Hover-Disaster/Strelka-Flight-Computer/Documentation/High Quality Gyro Comparison.xlsx

Name | Distributor | Price | Axes | Measurement range (deg/s) | Angular random walk (deg/h) | Bias instability (deg/h) | Sensitivity (mdeg/s/digit) | Sensitivity vs temperature (+/-) | Zero rate level (deg/s)(+/-) | Change zero rate level vs temperature (deg/s/degC)(+/-) | Linearity error | Noise density (deg/s/sqrt(Hz)) | Max output data rate (Hz)
I3G4250DTR | Mouser | $18.68 | xyz | 245-2000 |  |  | 8.75 | 2% | 10 | 0.03 | 0.20% | 0.03 | 840
IAM-20380 | Mouser | $30.72 | xyz | 250-2000 |  |  |  |  | -0.8 | 1 | 0.10% | 0.005 | 8000
ASM330LHHXTR | Mouser | $22.68 | xyz | 125-4000 | 0.21 | 3 |  | 2% | 2 |  | 0.01% | 0.005 | 6667
ADXRS453 | Digikey | $221.59 | xyz |  |  |  |  |  |  |  |  | 0.015
