Hover-Disaster/Strelka-Flight-Computer/Strelka_Flight_Computer/Strelka_Flight_Computer.kicad_pcb

## KiCad design Strelka_Flight_Computer/Strelka_Flight_Computer.kicad_pcb (2023-12-13)

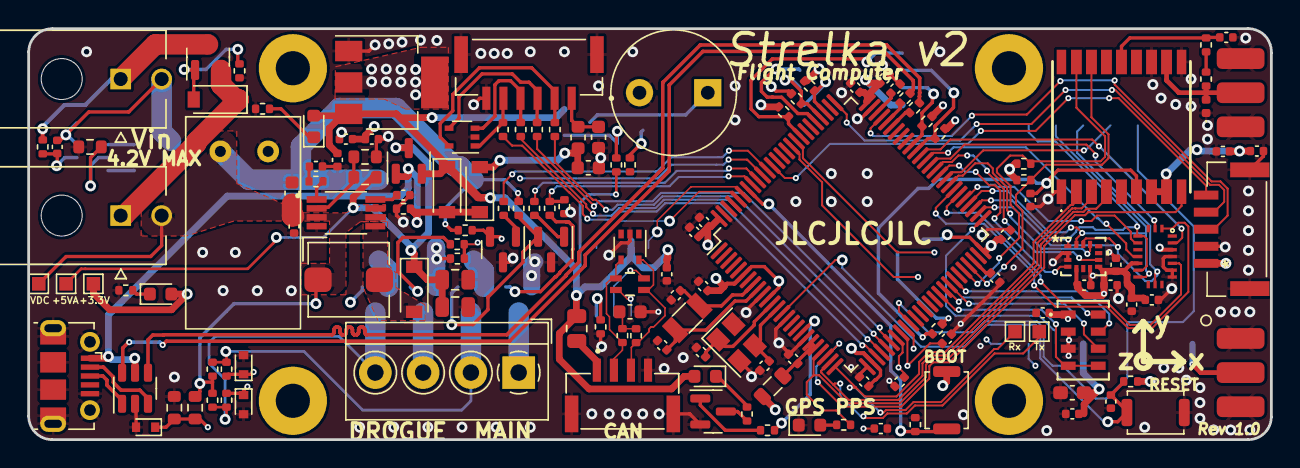
[picture p1: board Strelka_Flight_Computer.kicad_pcb from above]

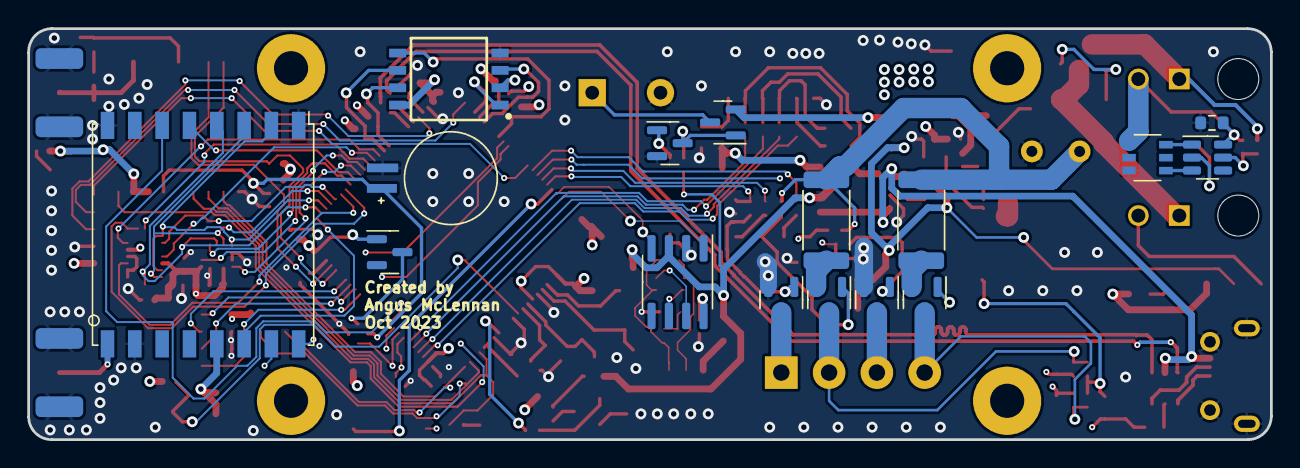
[picture p2: board Strelka_Flight_Computer.kicad_pcb from below]

Board: 4 copper layers, 91.0 x 30.1 mm, 165 parts (16 on the bottom side), 124 nets.

Parts:
AE1, AE2: Antenna_Shield; STA-10201
BT2: MS621FE-FL11E; BAT_MS621FE-FL11E
BZ3: Buzzer; HNB09A05
C1, C2, C4, C5, C6, C10, C28, C29, C30, C31, C39, C48, C50, C52, C53, C54, C60, C61, C66: 100n; C_0402_1005Metric
C3, C7, C8, C40: 10u; C_0402_1005Metric
C9, C12, C13: 10n; C_0402_1005Metric
C11: 10u; C_0603_1608Metric_Pad1.08x0.95mm_HandSolder
C14, C55: 22u; C_0805_2012Metric
C15: 4.7n; C_0603_1608Metric
C26, C27: 2.2u; C_0603_1608Metric
C37: NC; C_0402_1005Metric
C38: 4.7u; C_0402_1005Metric
C41: 1500u; ULR158M0JF1ARR
C46: 22u; C_0603_1608Metric
C47, C49: 1u; C_0402_1005Metric
C51: 2.2n; C_0402_1005Metric
C62, C63: 18p; C_0402_1005Metric
C64, C65: 15p; C_0402_1005Metric
C67, C68: 2.2u; C_0402_1005Metric
D1, D2, D4: B5819W; D_SOD-123
D3, D5, D13: BZT52C3V6T; D_SOD-523
D6, D7: SP0504BAJT; SOT-353_SC-70-5
D10: ESD9B3.3ST5G; D_0402_1005Metric
D11: BAT54C; SOT-23
D12: LED_GREEN; LED_0603_1608Metric
D14: DSK34; D_SOD-123
D18: RED LED; LED_0603_1608Metric
D19: YELLOW LED; LED_0603_1608Metric
D20: BLUE LED; LED_0603_1608Metric
F1: MF-PSHT035KX-2; R_0805_2012Metric
FB2: BLM18PG221SN1D; L_0603_1608Metric
FB3: HZ1005K182TFB03; R_0402_1005Metric
FL1: 744231121; CHIP_31121_WRE
H1, H2, H3, H4: MountingHole; MountingHole_2.5mm_Pad
IC1: XTSD04GLGEAG; SON127P800X600X95-8N
IC2: MAX-M10S-00B; MAXM10S00B
J2: Conn_01x04; JST_SM04B-GHS-TB(LF)(SN)-
J3: DB125-3.5-4P-GN-S; TerminalBlock_4Ucon_1x04_P3.50mm_Horizontal
J4: SM06B-GHS-TB(LF)(SN); JST_SM06B-GHS-TB(LF)(SN)
J6: USB_B_Micro; USB_Micro-B_Molex-105017-0001
J7: Conn_01x02; MOLEX_43045-0200
J8: Conn_01x07; SM05B-GHS-TBLFSN
L2: 6u; L_Bourns_SRP5030T
L4: 10u; L_0805_2012Metric
MOSFET1: DMG6968UDM-7
Q1, Q2: CJK2333; SOT-23
Q4, Q9, Q17: AO3401A; SOT-23
Q5, Q10: AP2300; SOT-23
Q6, Q11: MMBT2222; SOT-23
Q15, Q16: AO3400A; SOT-23
R1: 0R; R_0603_1608Metric
R2, R3, R4, R5, R6, R8, R81: 100k; R_0402_1005Metric
R7: 330R; R_0402_1005Metric
R9: 2.7k; R_0603_1608Metric
R10, R11, R12, R16, R17, R31, R51, R56, R57, R74, R77, R78, R80: 1k; R_0402_1005Metric
R13, R26: 60R4; R_0402_1005Metric
R14, R15, R61, R75, R79, R86, R87: 10k; R_0402_1005Metric
R18, R19, R21, R65, R76: 33R; R_0402_1005Metric
R20, R23, R24, R25, R35: 47k; R_0402_1005Metric
R22, R84: 10R; R_0402_1005Metric
R27, R47: 2R; R_2512_6332Metric
R55: 0R; R_0402_1005Metric
R59: 13k; R_0603_1608Metric
R60: 47k; R_0603_1608Metric
R62: 82k; R_0603_1608Metric
R63: 27k; R_0603_1608Metric
SW1: SW_DIP_x01; MOLEX_43045-0200
SW6, SW7: TS-1185-C-A-A-A; SW_Push_SPST_NO_Alps_SKRK
TP1, TP3, TP4, TP9, TP10: TestPoint; TestPoint_Pad_1.0x1.0mm
U1: ASM330LHHXTR; QFN_LHHXTR_STM
U2: AP9101CK6; SOT-23-6
U3: AMS1117-3.3; SOT-223-3_TabPin2
U4: RFM95W-915S2; HOPERF_RFM9XW_SMD
U5: MCP2551-I-SN; SOIC-8_3.9x4.9mm_P1.27mm
U6: STM32H743VITx; LQFP-100_14x14mm_P0.5mm
U8: USBLC6-2SC6; SOT-23-6
U11: BMX055
U12: MS561101BA03-50
U16: TPS61085DGKR; SOP65P490X110-8N
Y5: Q13FC1350000400; Crystal_SMD_3215-2Pin_3.2x1.5mm
Y6: X1E0000210834; Crystal_SMD_SeikoEpson_TSX3225-4Pin_3.2x2.5mm

Connections:
+3.3V: C2.1, C3.1, C4.1, C7.1, C8.1, C10.1, C11.1, C28.1, C29.1, C30.1, C31.1, C39.1, C40.1, C50.1, C52.1, C53.1, C54.1, C60.1, C61.1, D11.1, D19.2 (A), IC1.8 (VDD,_POWER_SUPPLY), IC2.7 (V_IO), IC2.8 (VCC), J8.1, L4.1, R20.1, R23.1, R24.1, R25.1, R35.1, R79.2, R86.2, R87.2, SW6.2, TP4.1, U1.5 (Vdd_IO), U1.8 (Vdd), U3.2 (VO), U4.13 (3.3V), U6.6 (VBAT), U6.11 (VDD), U6.27 (VDD), U6.50 (VDD), U6.75 (VDD), U6.100 (VDD), U11.3 (VDD), U11.13 (VDDIO), U12.1 (VDD)
+5V: C1.1, C5.1, D2.1 (K), D18.2 (A), D20.2 (A), F1.1, Q2.2 (S), Q17.2 (S), R81.2, U3.3 (VI), U5.3 (VDD)
+5VA: C14.1, C55.1, D14.1 (K), Q2.3 (D), R62.2, TP3.1
+5VD: C26.2, D4.2 (A), FB2.2
+BATT: J7.1, Q1.3 (D), R7.1
-BATT: C6.2, J7.2, MOSFET1.1 (S1), R1.1, U2.6 (VSS)
/915MHz_Radio/CS_RF: U4.5 (NSS), U6.59 (PD12)
/915MHz_Radio/IO0_RF: U4.14 (DIO0), U6.51 (PB12)
/915MHz_Radio/IO1_RF: U4.15 (DIO1), U6.84 (PD3)
/915MHz_Radio/IO2_RF: U4.16 (DIO2), U6.85 (PD4)
/915MHz_Radio/LoRa_Sig: AE1.1 (A), U4.9 (ANT)
/915MHz_Radio/RESET_RF: U4.6 (RESET), U6.35 (PB1)
/915MHz_Radio/SPI_CLK: U1.13 (SCL), U4.4 (SCK), U6.52 (PB13), U11.9 (SCX)
/915MHz_Radio/SPI_MISO: U1.1 (SDO/SA0), U4.2 (MISO), U6.53 (PB14), U11.12 (SDO2), U11.17 (SDO1)
/915MHz_Radio/SPI_MOSI: U1.14 (SDA), U4.3 (MOSI), U6.54 (PB15), U11.11 (SDX)
/Actuators/D+: J3.4, Q4.3 (D), R14.2, R16.2
/Actuators/D-: J3.3, Q5.3 (D)
/Actuators/DROGUE_CONT: C12.1, D3.1 (K), R14.1, U6.33 (PC5)
/Actuators/DROGUE_H: R10.1, U6.90 (PB4)
/Actuators/DROGUE_L: R5.2, R31.1, U6.91 (PB5)
/Actuators/EXT_SPI_CS: R21.2, U6.28 (PA4)
/Actuators/EXT_SPI_MISO: R65.2, U6.30 (PA6)
/Actuators/EXT_SPI_MOSI: R18.2, U6.31 (PA7)
/Actuators/EXT_SPI_SCK: R19.2, U6.29 (PA5)
/Actuators/Ematch_Drogue1/em+: Q4.2 (S), R27.2
/Actuators/Ematch_Main/em+: Q9.2 (S), R47.2
/Actuators/M+: J3.2, Q9.3 (D), R15.2, R17.2
/Actuators/M-: J3.1, Q10.3 (D)
/Actuators/MAIN_CONT: C13.1, D5.1 (K), R15.1, U6.34 (PB0)
/Actuators/MAIN_H: R11.1, U6.92 (PB6)
/Actuators/MAIN_L: R6.2, R51.1, U6.93 (PB7)
/Data_Interfaces/CANH: FL1.4, U5.7 (CANH)
/Data_Interfaces/CANL: FL1.2, U5.6 (CANL)
/Data_Interfaces/CAN_+: D7.4 (K), FL1.3, J2.2, R13.1
/Data_Interfaces/CAN_-: D7.5 (K), FL1.1, J2.3, R26.2
/Data_Interfaces/CAN_RXD: U5.4 (RXD), U6.95 (PB8)
/Data_Interfaces/CAN_TXD: U5.1 (TXD), U6.96 (PB9)
/Data_Interfaces/USB2_D+: J6.3 (D+), U8.1 (I/O1)
/Data_Interfaces/USB2_D-: J6.2 (D-), U8.3 (I/O2)
/Data_Interfaces/USB_D+: R22.2, U8.6 (I/O1)
/Data_Interfaces/USB_D-: R84.2, U8.4 (I/O2)
/Data_Interfaces/V_CAN: F1.2, J2.1
/Data_Interfaces/tap: C15.1, R13.2, R26.1
/Data_Logging/CLK: IC1.3 (CLK,_CLOCK_SIGNAL), U6.80 (PC12)
/Data_Logging/CMD: IC1.5 (CMD,_COMMAND_SIGNAL), R35.2, U6.83 (PD2)
/Data_Logging/SD0: IC1.6 (SD0,_I/O_PIN), R25.2, U6.65 (PC8)
/Data_Logging/SD1: IC1.7 (SD1,_I/O_PIN), R24.2, U6.66 (PC9)
/Data_Logging/SD2: IC1.1 (SD2,_I/O_PIN), R23.2, U6.78 (PC10)
/Data_Logging/SD3: IC1.2 (SD3,_I/O_PIN), R20.2, U6.79 (PC11)
/Power/BATT_VOLT: C9.1, D13.1 (K), R59.1, R60.2, U6.32 (PC4)
/Power/SW_IN: D1.1 (K), Q1.2 (S), SW1.1
/STM32H743/BOOT0: R75.2, SW6.1, U6.94 (BOOT0)
/STM32H743/D+: R22.1, U6.71 (PA12)
/STM32H743/D-: R84.1, U6.70 (PA11)
/STM32H743/EXTI6: U6.63 (PC6), U11.14 (INT3)
/STM32H743/EXTI7: U6.64 (PC7), U11.2 (DRDYM)
/STM32H743/EXTI13: U1.4 (INT1), U6.60 (PD13)
/STM32H743/EXTI14: U1.9 (INT2), U6.61 (PD14)
/STM32H743/EXTI15: U6.62 (PD15), U11.19 (INT1)
/STM32H743/GPS_RST: IC2.9 (RESET_N), U6.23 (PA1)
/STM32H743/I2C2_SCL: IC2.17 (SCL), R86.1, U6.46 (PB10)
/STM32H743/I2C2_SDA: IC2.16 (SDA), R87.1, U6.47 (PB11)
/STM32H743/INDICATOR_LED: R74.2, U6.18 (PC3_C)
/STM32H743/NRST: C49.1, R79.1, SW7.2, U6.14 (NRST)
/STM32H743/OSC32_IN: C62.1, U6.8 (PC14), Y5.1
/STM32H743/OSC32_OUT: C63.1, U6.9 (PC15), Y5.2
/STM32H743/OSC_IN: C64.1, U6.12 (PH0), Y6.1
/STM32H743/OSC_OUT: C65.1, U6.13 (PH1), Y6.3
/STM32H743/SPI2_NSS1: U6.55 (PD8), U11.16 (CSB1)
/STM32H743/SPI2_NSS2: U6.56 (PD9), U11.5 (CSB2)
/STM32H743/SPI2_NSS3: U6.57 (PD10), U11.20 (CSB3)
/STM32H743/SPI2_NSS4: U1.12 (CS), U6.58 (PD11)
/STM32H743/SPI4_MISO: U6.43 (PE13), U12.6 (SDO)
/STM32H743/SPI4_MOSI: U6.44 (PE14), U12.7 (SDI/SDA)
/STM32H743/SPI4_NSS: U6.41 (PE11), U12.4 (CSB), U12.5 (CSB)
/STM32H743/SPI4_SCK: U6.42 (PE12), U12.8 (SCLK)
/STM32H743/SWCLK: J8.4, U6.76 (PA14)
/STM32H743/SWDIO: J8.3, U6.72 (PA13)
/STM32H743/SWO: J8.5, U6.89 (PB3)
/STM32H743/USART2_RX: IC2.2 (TXD), TP9.1, U6.25 (PA3)
/STM32H743/USART2_TX: IC2.3 (RXD), TP10.1, U6.24 (PA2)
/STM32H743/VDDA: C66.1, L4.2, U6.20 (VREF+), U6.21 (VDDA)
/Sensors/MAX-M10S-00B/PPS: IC2.4 (TIMEPULSE), R57.1, U6.22 (PA0)
/Sensors/MAX-M10S-00B/RF_IN: AE2.1 (A), D10.2 (A2), FB3.1, IC2.11 (RF_IN)
/Sensors/MAX-M10S-00B/VCC_RF: C37.1, IC2.14 (VCC_RF), R55.1
/Sensors/MAX-M10S-00B/V_BKCP: BT2.+ (r~), C38.1, IC2.6 (V_BCKP), R56.1
GND: AE1.2 (Shield), AE2.2 (Shield), BT2.-, BZ3.2 (+), C1.2, C2.2, C3.2, C4.2, C5.2, C7.2, C8.2, C9.2, C10.2, C11.2, C12.2, C13.2, C14.2, C15.2, C26.1, C27.1, C28.2, C29.2, C30.2, C31.2, C37.2, C38.2, C39.2, C40.2, C41.2, C46.2, C47.2, C48.2, C49.2, C50.2, C51.2, C52.2, C53.2, C54.2, C55.2, C60.2, C61.2, C62.2, C63.2, C64.2, C65.2, C66.2, C67.2, C68.2, D3.2 (A), D5.2 (A), D6.2 (A), D7.2 (A), D10.1 (A1), D12.1 (K), D13.2 (A), IC1.4 (VSS,_GROUND), IC2.1 (GND_1), IC2.10 (GND_2), IC2.12 (GND_3), J2.4, J2.5, J2.6, J4.6, J4.S1 (SHIELD), J4.S2 (SHIELD), J6.5 (GND), J6.6 (Shield), J8.2, J8.6, J8.7, MOSFET1.3 (S2), Q5.2 (S), Q6.3 (E), Q10.2 (S), Q11.3 (E), Q15.2 (S), Q16.2 (S), R1.2, R3.1, R5.1, R6.1, R8.1, R9.2, R12.2, R60.1, R63.1, R75.1, R77.1, R78.1, SW7.1, U1.2 (MSDA), U1.3 (MSCL), U1.7 (GND), U3.1 (GND), U4.1 (GND), U4.8 (GND), U4.10 (GND), U5.2 (VSS), U6.10 (VSS), U6.15 (PC0), U6.19 (VSSA), U6.26 (VSS), U6.49 (VSS), U6.74 (VSS), U6.99 (VSS), U8.2 (GND), U11.4 (GNDA), U11.6 (GNDIO), U11.7 (PS), U12.2 (PS), U12.3 (GND), U16.4 (PGND), Y6.2, Y6.4
unnamed: BZ3.1 (-), Q17.3 (D)
unnamed: C27.2, FB2.1, J4.1
unnamed: C51.1, R61.1
unnamed: C67.1, U6.48 (VCAP)
unnamed: C68.1, U6.73 (VCAP)
unnamed: D1.2 (A), Q1.1 (G), R3.2
unnamed: D6.1 (K), J4.5, R21.1
unnamed: D6.3 (K), J4.4, R19.1
unnamed: D6.4 (K), J4.3, R18.1
unnamed: D6.5 (K), J4.2, R65.1
unnamed: D11.3, R56.2
unnamed: D12.2 (A), R57.2
unnamed: D14.2 (A), L2.2, U16.5 (SW)
unnamed: D18.1 (K), R76.2
unnamed: D19.1 (K), R77.2
unnamed: D20.1 (K), R78.2
unnamed: FB3.2, R55.2
unnamed: MOSFET1.6 (G1), U2.1 (DO)
unnamed: MOSFET1.4 (G2), U2.3 (CO)
unnamed: Q4.1 (G), Q6.2 (C), R2.1
unnamed: Q5.1 (G), R31.2
unnamed: Q6.1 (B), R10.2
unnamed: Q10.1 (G), R51.2
unnamed: Q11.1 (B), R11.2
unnamed: Q9.1 (G), Q11.2 (C), R4.1
unnamed: Q15.3 (D), R76.1
unnamed: Q15.1 (G), R74.1
unnamed: Q16.3 (D), Q17.1 (G), R81.1
unnamed: Q16.1 (G), R80.1
unnamed: C6.1, R7.2, U2.5 (VDD)
unnamed: R9.1, U2.2 (VM)
unnamed: R12.1, U5.8 (Rs)
unnamed: R61.2, U16.1 (COMP)
unnamed: R62.1, R63.2, U16.2 (FB)
unnamed: C48.1, U16.8 (SS)
VBUS: D2.2 (A), D4.1 (K), J6.1 (VBUS), Q2.1 (G), R8.2, U8.5 (VBUS)
VDC: C41.1, C46.1, C47.1, L2.1, R2.2, R4.2, R16.1, R17.1, R27.1, R47.1, R59.2, SW1.2, TP1.1, U16.3 (EN), U16.6 (IN), U16.7 (FREQ)
