Hover-Disaster/Strelka-Flight-Computer/Test IOC files/H7_FC_Test.ioc

Mcu.UserName=STM32H743VGTx
PA0.GPIO_Label=GPS_PPS
PA0.Signal=GPXTI0
PA1.GPIO_Label=GPS_RST
PA1.Signal=GPIO_Output
PA11.Signal=USB_OTG_FS_DM
PA12.Signal=USB_OTG_FS_DP
PA2.Signal=USART2_TX
PA3.Signal=USART2_RX
PA4.Signal=SPI1_NSS
PA5.Signal=SPI1_SCK
PA6.Signal=SPI1_MISO
PA7.Signal=SPI1_MOSI
PB0.GPIO_Label=MAIN_CONT
PB0.Signal=ADCx_INP9
PB1.GPIO_Label=RESET_RF
PB1.Signal=GPIO_Output
PB10.Signal=I2C2_SCL
PB11.Signal=I2C2_SDA
PB12.GPIO_Label=IO0_RF
PB12.Signal=GPXTI12
PB13.Signal=SPI2_SCK
PB14.Signal=SPI2_MISO
PB15.Signal=SPI2_MOSI
PB5.GPIO_Label=DROGUE_L
PB5.Signal=GPIO_Output
PB6.GPIO_Label=MAIN_H
PB6.Signal=GPIO_Output
PB7.GPIO_Label=MAIN_L
PB7.Signal=GPIO_Output
PB8.Signal=FDCAN1_RX
PB9.Signal=FDCAN1_TX
PC0.GPIO_Label=SD_Det
PC0.Signal=GPIO_Input
PC10.Signal=SDMMC1_D2
PC11.Signal=SDMMC1_D3
PC12.Signal=SDMMC1_CK
PC3_C.GPIO_Label=INDICATOR
PC3_C.Signal=GPIO_Output
PC4.GPIO_Label=BATT_SENSE
PC4.Signal=ADCx_INP4
PC5.GPIO_Label=DROGUE_CONT
PC5.Signal=ADCx_INP8
PC6.Signal=GPXTI6
PC7.Signal=GPXTI7
PC8.Signal=SDMMC1_D0
PC9.Signal=SDMMC1_D1
PD10.Signal=GPIO_Output
PD11.Signal=GPIO_Output
PD12.Signal=GPIO_Output
PD13.Signal=GPXTI13
PD14.Signal=GPXTI14
PD15.Signal=GPXTI15
PD2.Signal=SDMMC1_CMD
PD3.Signal=GPXTI3
PD8.Signal=GPIO_Output
PD9.Signal=GPIO_Output
PE11.Signal=SPI4_NSS
PE12.Signal=SPI4_SCK
PE13.Signal=SPI4_MISO
PE14.Signal=SPI4_MOSI
