Hover-Disaster/Strelka-Flight-Computer/(commit log)

2023-10-09 Added pcb files
    [915MHz_Radio.kicad_sch, Actuators.kicad_sch, BMX055.kicad_sch, Continuity_Testing.kicad_sch, Data_Interfaces.kicad_sch, Data_Logging.kicad_sch, Ematch.kicad_sch, L80-M39.kicad_sch]
2023-10-09 Started design for V2
    [915MHz_Radio.kicad_sch, Actuators.kicad_sch, Data_Interfaces.kicad_sch, Ematch.kicad_sch, MAX-M10S-00B.kicad_sch, Power.kicad_sch, STM32F407.kicad_sch, Sensors.kicad_sch]
2023-10-10 Changes main processor to h4745
    [ASM330LHHXTR.kicad_sch, High Quality Gyro Comparison.xlsx, STM32F407.kicad_sch, STM32H743.kicad_sch, Sensors.kicad_sch, Strelka_Flight_Computer.kicad_pcb, Strelka_Flight_Computer.kicad_sch]
2023-10-11 Started component placement
    [Ematch.kicad_sch, STM32H743.kicad_sch, Strelka_Flight_Computer.kicad_pcb, Strelka_Flight_Computer.kicad_sch]
2023-10-12 Changed design rules
    [ASM330LHHXTR.kicad_sch, BMX055.kicad_sch, Data_Logging.kicad_sch, MAX-M10S-00B.kicad_sch, MS561101BA03-50.kicad_sch, Strelka_Flight_Computer.kicad_pcb]
2023-10-13 Routing starting
    [ASM330LHHXTR.kicad_sch, Actuators.kicad_sch, Data_Interfaces.kicad_sch, Data_Logging.kicad_sch, Ematch.kicad_sch, MAX-M10S-00B.kicad_sch, Power.kicad_sch, STM32H743.kicad_sch]
2023-10-14 Continued routing
    [915MHz_Radio.kicad_sch, ASM330LHHXTR.kicad_sch, BMX055.kicad_sch, Data_Interfaces.kicad_sch, Data_Logging.kicad_sch, MAX-M10S-00B.kicad_sch, MS561101BA03-50.kicad_sch, Power.kicad_sch]
2023-10-15 Routing complete
    [915MHz_Radio.kicad_sch, Actuators.kicad_sch, Ematch.kicad_sch, MAX-M10S-00B.kicad_sch, Power.kicad_sch, STM32H743.kicad_sch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]
2023-10-16 Created BOM
    [915MHz_Radio.kicad_sch, Actuators.kicad_sch, BMX055.kicad_sch, Data_Interfaces.kicad_sch, Data_Logging.kicad_sch, Ematch.kicad_sch, MAX-M10S-00B.kicad_sch, MS561101BA03-50.kicad_sch]
2023-10-16 Started BOM
    [Ematch.kicad_sch]
2023-10-17 Adjusted master bom
    [Strelka_Flight_Computer_MASTER.xlsx]
2023-10-17 Adjusted stackup to suit jlc standard stackups
    [Strelka_Flight_Computer-B_Cu.gbr, Strelka_Flight_Computer-B_Mask.gbr, Strelka_Flight_Computer-B_Paste.gbr, Strelka_Flight_Computer-B_Silkscreen.gbr, Strelka_Flight_Computer-Edge_Cuts.gbr, Strelka_Flight_Computer-F_Cu.gbr, Strelka_Flight_Computer-F_Mask.gbr, Strelka_Flight_Computer-F_Paste.gbr]
2023-10-19 Via stitched
    [Sensors.kicad_sch, Strelka_Flight_Computer.kicad_pcb]
2023-10-21 Added solder paste to BOM
    [Strelka_Flight_Computer_MASTER.xlsx]
2023-10-21 Adjusted bom available items
    [Strelka_Flight_Computer_MASTER.xlsx]
2023-10-25 Added lp filter caps to adc signals
    [Ematch.kicad_sch, Power.kicad_sch, STM32H743.kicad_sch, Strelka_Flight_Computer.kicad_pcb]
2023-10-29 Added LCSC mpn to all relevent parts
    [915MHz_Radio.kicad_sch, ASM330LHHXTR.kicad_sch, Actuators.kicad_sch, BMX055.kicad_sch, Data_Interfaces.kicad_sch, Data_Logging.kicad_sch, Ematch.kicad_sch, MAX-M10S-00B.kicad_sch]
2023-10-30 Completely exported to JLC
    [Ematch.kicad_sch, MAX-M10S-00B.kicad_sch, Power.kicad_sch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]
2023-11-07 Finalised BOM and sent order:
    [Data_Interfaces.kicad_sch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]
2023-12-13 Adj to BOM
    [STM32H743.kicad_sch, Strelka_Flight_Computer.kicad_pcb, Strelka_Flight_Computer.kicad_sch, Strelka_Flight_Computer_MASTER.xlsx]
2023-12-13 Adjusted changes after jlc tech team review
    [STM32H743.kicad_sch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]
